bao-eng/alpinetime-hw/0.2/alpinetime.kicad_pcb

## KiCad design 0.2/alpinetime.kicad_pcb (2024-12-16)

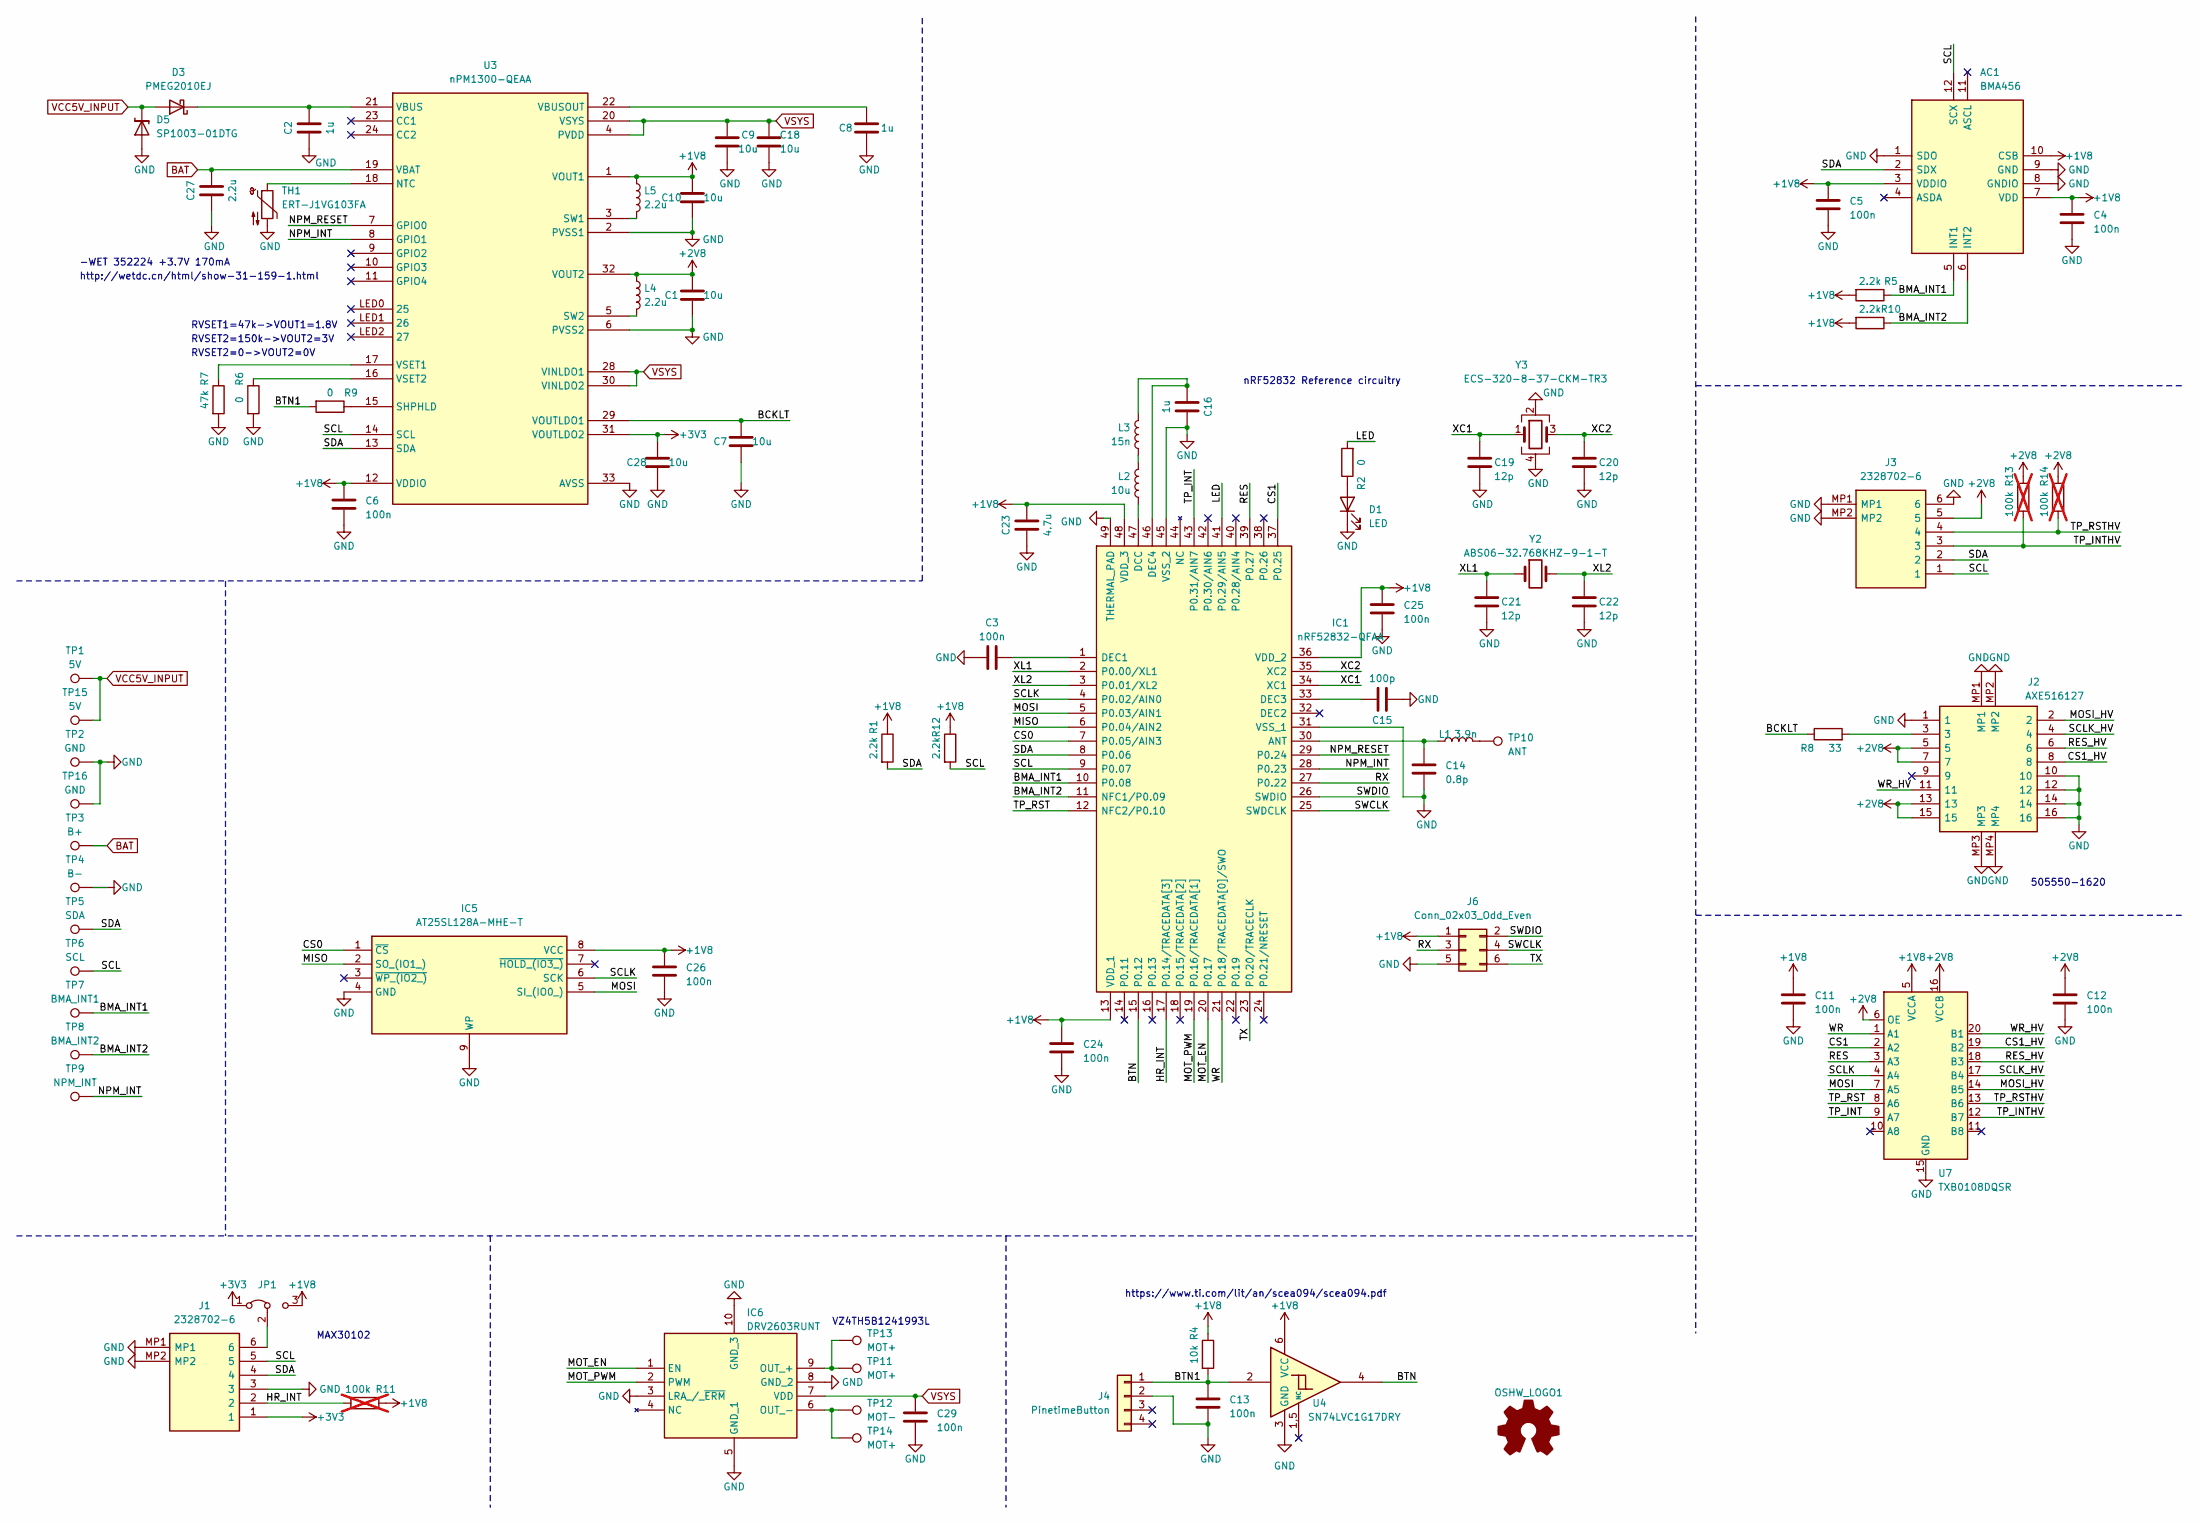
[picture p1: schematic alpinetime.kicad_sch, AlpineTime 0.2]

Parts:
AC1: BMA456; BOSCH_LGA-12; Mouser Part Number 262-BMA456
C1, C7, C9, C10, C18, C28: 10u; C_0603_1608Metric; MPN CL10A106KP8NNNC
C2, C8: 1u; C_0603_1608Metric
C3, C4, C5, C6, C11, C12, C13, C24, C25, C26, C29: 100n; C_0402_1005Metric; MPN GCM155R71C104KA55D
C14: 0.8p; C_0402_1005Metric; MPN GJM1555C1HR80WB01D
C15: 100p; C_0402_1005Metric; MPN GRM1555C1H101JA01D
C16: 1u; C_0603_1608Metric; MPN CL10B105KP8NNNC
C19, C20, C21, C22: 12p; C_0402_1005Metric; MPN GRM1555C1H120GA01D
C23: 4.7u; C_0603_1608Metric; MPN CL10A475KQ8NNNC
C27: 2.2u; C_0603_1608Metric; MPN CL10B105KP8NNNC
D1: LED; LED_0402_1005Metric; MPN APHHS1005LSECK/J3-PF
D3: PMEG2010EJ; SODFL2512X80N
D5: SP1003-01DTG; SODFL1406X65N
IC1: nRF52832-QFAA; QFN-48-1EP_6x6mm_P0.4mm_EP4.66x4.66mm; Mouser Part Number 949-NRF52832-QFAA-R7
IC5: AT25SL128A-MHE-T; SON127P600X500X60-9N-D; Mouser Part Number 988-AT25SL128A-MHE-T
IC6: DRV2603RUNT; QFN50P200X200X80-10N-D; Mouser Part Number 595-DRV2603RUNT
J1, J3: 2328702-6; 23287026; Mouser Part Number 571-2328702-6
J2: AXE516127; Mouser Part Number 679-AXE516127
J4: PinetimeButton
J6: Conn_02x03_Odd_Even; PinHeader_2x03_P1.27mm_Vertical
JP1: R_0402_1005Metric_jumper
L1: 3.9n; L_0402_1005Metric; MPN MCL1005-3R9-R
L2: 10u; L_0603_1608Metric; MPN MLZ1608M100WT000
L3: 15n; L_0402_1005Metric; MPN LQG15HS15NJ02D
L4, L5: 2.2u; CIGT201610; MPN CIGT201610EH2R2MNE
OSHW_LOGO1: Logo_Open_Hardware_Small; OSHW_logo.kicad_mod_silkscreen-front_5mm
R1, R5, R10, R12: 2.2k; R_0402_1005Metric; MPN RT0402FRE072K2L
R2: 0; R_0402_1005Metric; MPN RC0402FR-07330RL
R4: 10k; R_0402_1005Metric; MPN RT0402FRE0710KL
R6, R9: 0; R_0402_1005Metric; MPN RT0402FRE072K2L
R7: 47k; R_0402_1005Metric; MPN RT0402FRE072K2L
R8: 33; R_0402_1005Metric; MPN RT0402FRE0733RL
R11, R13, R14: 100k; R_0402_1005Metric; MPN RT0402FRE07100KL; not fitted
TH1: ERT-J1VG103FA; R_0603_1608Metric
TP1: 5V; TestPoint_Pad_D2.0mm
TP2: GND; TestPoint_Pad_D2.0mm
TP3: B+; TestPoint_Pad_Oval_1.0x2.0mm
TP4: B-; TestPoint_Pad_Oval_1.0x2.0mm
TP5: SDA; TestPoint_Pad_D1.0mm
TP6: SCL; TestPoint_Pad_D1.0mm
TP7: BMA_INT1; TestPoint_Pad_D1.0mm
TP8: BMA_INT2; TestPoint_Pad_D1.0mm
TP9: NPM_INT; TestPoint_Pad_D1.0mm
TP10: ANT; TestPoint_Pad_D1.5mm
TP11: MOT+; Pad_7.0x2.5mm
TP12: MOT-; Pad_7.0x2.5mm
TP13, TP14: MOT+; TestPoint_Pad_D1.0mm
TP15: 5V; TestPoint_Pad_D1.0mm
TP16: GND; TestPoint_Pad_D1.0mm
U3: nPM1300-QEAA; QFN-32-1EP_5x5mm_P0.5mm_EP3.3x3.3mm
U4: SN74LVC1G17DRY; SON50P100X145X60-6N
U7: TXB0108DQSR; USON-20_2x4mm_P0.4mm
Y2: ABS06-32.768KHZ-9-1-T; ABS0612732768KHZT
Y3: ECS-320-8-37-CKM-TR3; ECS320837CKMTR3

Connections:
+1V8: AC1.3 (VDDIO), AC1.7 (VDD), AC1.10 (CSB), C4.1, C5.1, C6.1, C10.2, C11.1, C23.2, C24.2, C25.2, C26.1, IC1.13 (VDD_1), IC1.36 (VDD_2), IC1.48 (VDD_3), IC5.8 (VCC), J6.1, JP1.3 (B), L5.1, R1.1, R4.1, R5.2, R10.2, R11.1, R12.1, U3.1 (VOUT1), U3.12 (VDDIO), U4.6 (VCC), U7.5 (VCCA)
+2V8: C1.2, C12.1, J2.5, J2.7, J2.13, J2.15, J3.5, L4.1, R13.1, R14.1, U3.32 (VOUT2), U7.6 (OE), U7.16 (VCCB)
+3V3: C28.2, J1.1, JP1.1 (A), U3.31 (VOUTLDO2)
/BCKLT: C7.2, R8.1, U3.29 (VOUTLDO1)
/BMA_INT1: AC1.5 (INT1), IC1.10 (P0.08), R5.1, TP7.1
/BMA_INT2: AC1.6 (INT2), IC1.11 (NFC1/P0.09), R10.1, TP8.1
/BTN: IC1.15 (P0.12), U4.4
/BTN1: C13.1, J4.1, R4.2, R9.2, U4.2
/CS0: IC1.7 (P0.05/AIN3), IC5.1 (~CS)
/CS1: IC1.37 (P0.25), U7.2 (A2)
/CS1_HV: J2.8, U7.19 (B2)
/HR_INT: IC1.17 (P0.14/TRACEDATA[3]), J1.2, R11.2
/LED: IC1.41 (P0.29/AIN5), R2.2
/MISO: IC1.6 (P0.04/AIN2), IC5.2 (SO_(IO1_))
/MOSI: IC1.5 (P0.03/AIN1), IC5.5 (SI_(IO0_)), U7.7 (A5)
/MOSI_HV: J2.2, U7.14 (B5)
/MOT_EN: IC1.20 (P0.17), IC6.1 (EN)
/MOT_PWM: IC1.19 (P0.16/TRACEDATA[1]), IC6.2 (PWM)
/NPM_INT: IC1.28 (P0.23), TP9.1, U3.8 (GPIO1)
/NPM_RESET: IC1.29 (P0.24), U3.7 (GPIO0)
/RES: IC1.39 (P0.27), U7.3 (A3)
/RES_HV: J2.6, U7.18 (B3)
/RX: IC1.27 (P0.22), J6.3
/SCL: AC1.12 (SCX), IC1.9 (P0.07), J1.5, J3.1, R12.2, TP6.1, U3.14 (SCL)
/SCLK: IC1.4 (P0.02/AIN0), IC5.6 (SCK), U7.4 (A4)
/SCLK_HV: J2.4, U7.17 (B4)
/SDA: AC1.2 (SDX), IC1.8 (P0.06), J1.4, J3.2, R1.2, TP5.1, U3.13 (SDA)
/SWCLK: IC1.25 (SWDCLK), J6.4
/SWDIO: IC1.26 (SWDIO), J6.2
/TP_INT: IC1.43 (P0.31/AIN7), U7.9 (A7)
/TP_INTHV: J3.3, R13.2, U7.12 (B7)
/TP_RST: IC1.12 (NFC2/P0.10), U7.8 (A6)
/TP_RSTHV: J3.4, R14.2, U7.13 (B6)
/TX: IC1.23 (P0.20/TRACECLK), J6.6
/WR: IC1.21 (P0.18/TRACEDATA[0]/SWO), U7.1 (A1)
/WR_HV: J2.11, U7.20 (B1)
/XC1: C19.2, IC1.34 (XC1), Y3.1
/XC2: C20.2, IC1.35 (XC2), Y3.3
/XL1: C21.2, IC1.2 (P0.00/XL1), Y2.1
/XL2: C22.2, IC1.3 (P0.01/XL2), Y2.2
BAT: C27.2, TP3.1, U3.19 (VBAT)
GND: AC1.1 (SDO), AC1.8 (GNDIO), AC1.9 (GND), C1.1, C2.1, C3.1, C4.2, C5.2, C6.2, C7.1, C8.1, C9.1, C10.1, C11.2, C12.2, C13.2, C14.1, C15.1, C16.2, C18.1, C19.1, C20.1, C21.1, C22.1, C23.1, C24.1, C25.1, C26.2, C27.1, C28.1, C29.2, D1.1 (K), D5.2 (A), IC1.31 (VSS_1), IC1.45 (VSS_2), IC1.49 (THERMAL_PAD), IC5.4 (GND), IC5.9 (WP), IC6.3 (LRA_/_~ERM), IC6.5 (GND_1), IC6.8 (GND_2), IC6.10 (GND_3), J1.3, J1.MP1, J1.MP2, J2.1, J2.10, J2.12, J2.14, J2.16, J2.MP1, J2.MP2, J2.MP3, J2.MP4, J3.6, J3.MP1, J3.MP2, J4.2, J6.5, R6.2, R7.2, TH1.2, TP2.1, TP4.1, TP16.1, U3.2 (PVSS1), U3.6 (PVSS2), U3.33 (AVSS), U4.3 (GND), U7.15 (GND), Y3.2, Y3.4
unnamed: D1.2 (A), R2.1
unnamed: C2.2, D3.1 (K), U3.21 (VBUS)
unnamed: C14.2, IC1.30 (ANT), L1.1
unnamed: IC1.47 (DCC), L2.1
unnamed: C3.2, IC1.1 (DEC1)
unnamed: C15.2, IC1.33 (DEC3)
unnamed: C16.1, IC1.46 (DEC4), L3.2
unnamed: IC6.9 (OUT_+), TP11.1, TP13.1
unnamed: IC6.6 (OUT_-), TP12.1, TP14.1
unnamed: J2.3, R8.2
unnamed: J1.6, JP1.2 (C)
unnamed: L1.2, TP10.1
unnamed: L2.2, L3.1
unnamed: TH1.1, U3.18 (NTC)
unnamed: R9.1, U3.15 (SHPHLD)
unnamed: L5.2, U3.3 (SW1)
unnamed: L4.2, U3.5 (SW2)
unnamed: C8.2, U3.22 (VBUSOUT)
unnamed: R7.1, U3.17 (VSET1)
unnamed: R6.1, U3.16 (VSET2)
VCC5V_INPUT: D3.2 (A), D5.1 (K), TP1.1, TP15.1
VSYS: C9.2, C18.2, C29.1, IC6.7 (VDD), U3.4 (PVDD), U3.20 (VSYS), U3.28 (VINLDO1), U3.30 (VINLDO2)

Notes on the sheet:
https://www.ti.com/lit/an/scea094/scea094.pdf
VZ4TH5B1241993L
RVSET2=150k->VOUT2=3V
RVSET1=47k->VOUT1=1.8V
nRF52832 Reference circuitry
http://wetdc.cn/html/show-31-159-1.html
-WET 352224 +3.7V 170mA
505550-1620
MAX30102
RVSET2=0->VOUT2=0V

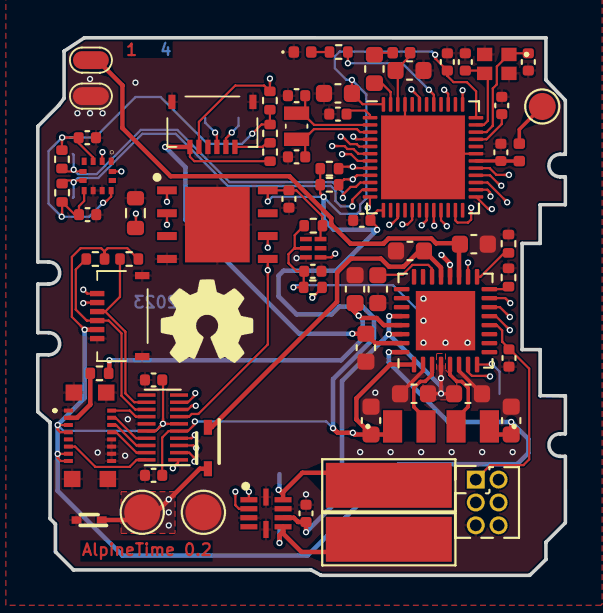
[picture p2: board 0.2/alpinetime.kicad_pcb from above]

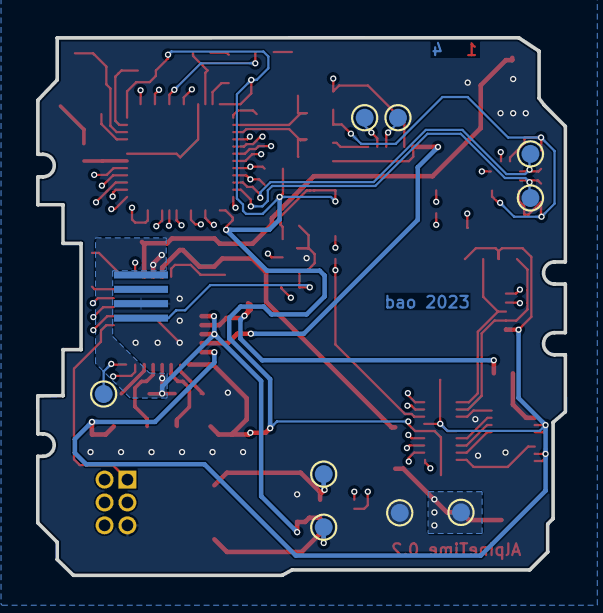
[picture p3: board 0.2/alpinetime.kicad_pcb from below]

Board: 4 copper layers, 29.3 x 29.9 mm, 82 parts (10 on the bottom side), 64 nets.
