bao-eng/alpinetime-hw/0.1/alpinetime.kicad_pcb

## KiCad design 0.1/alpinetime.kicad_pcb (2023-11-14)

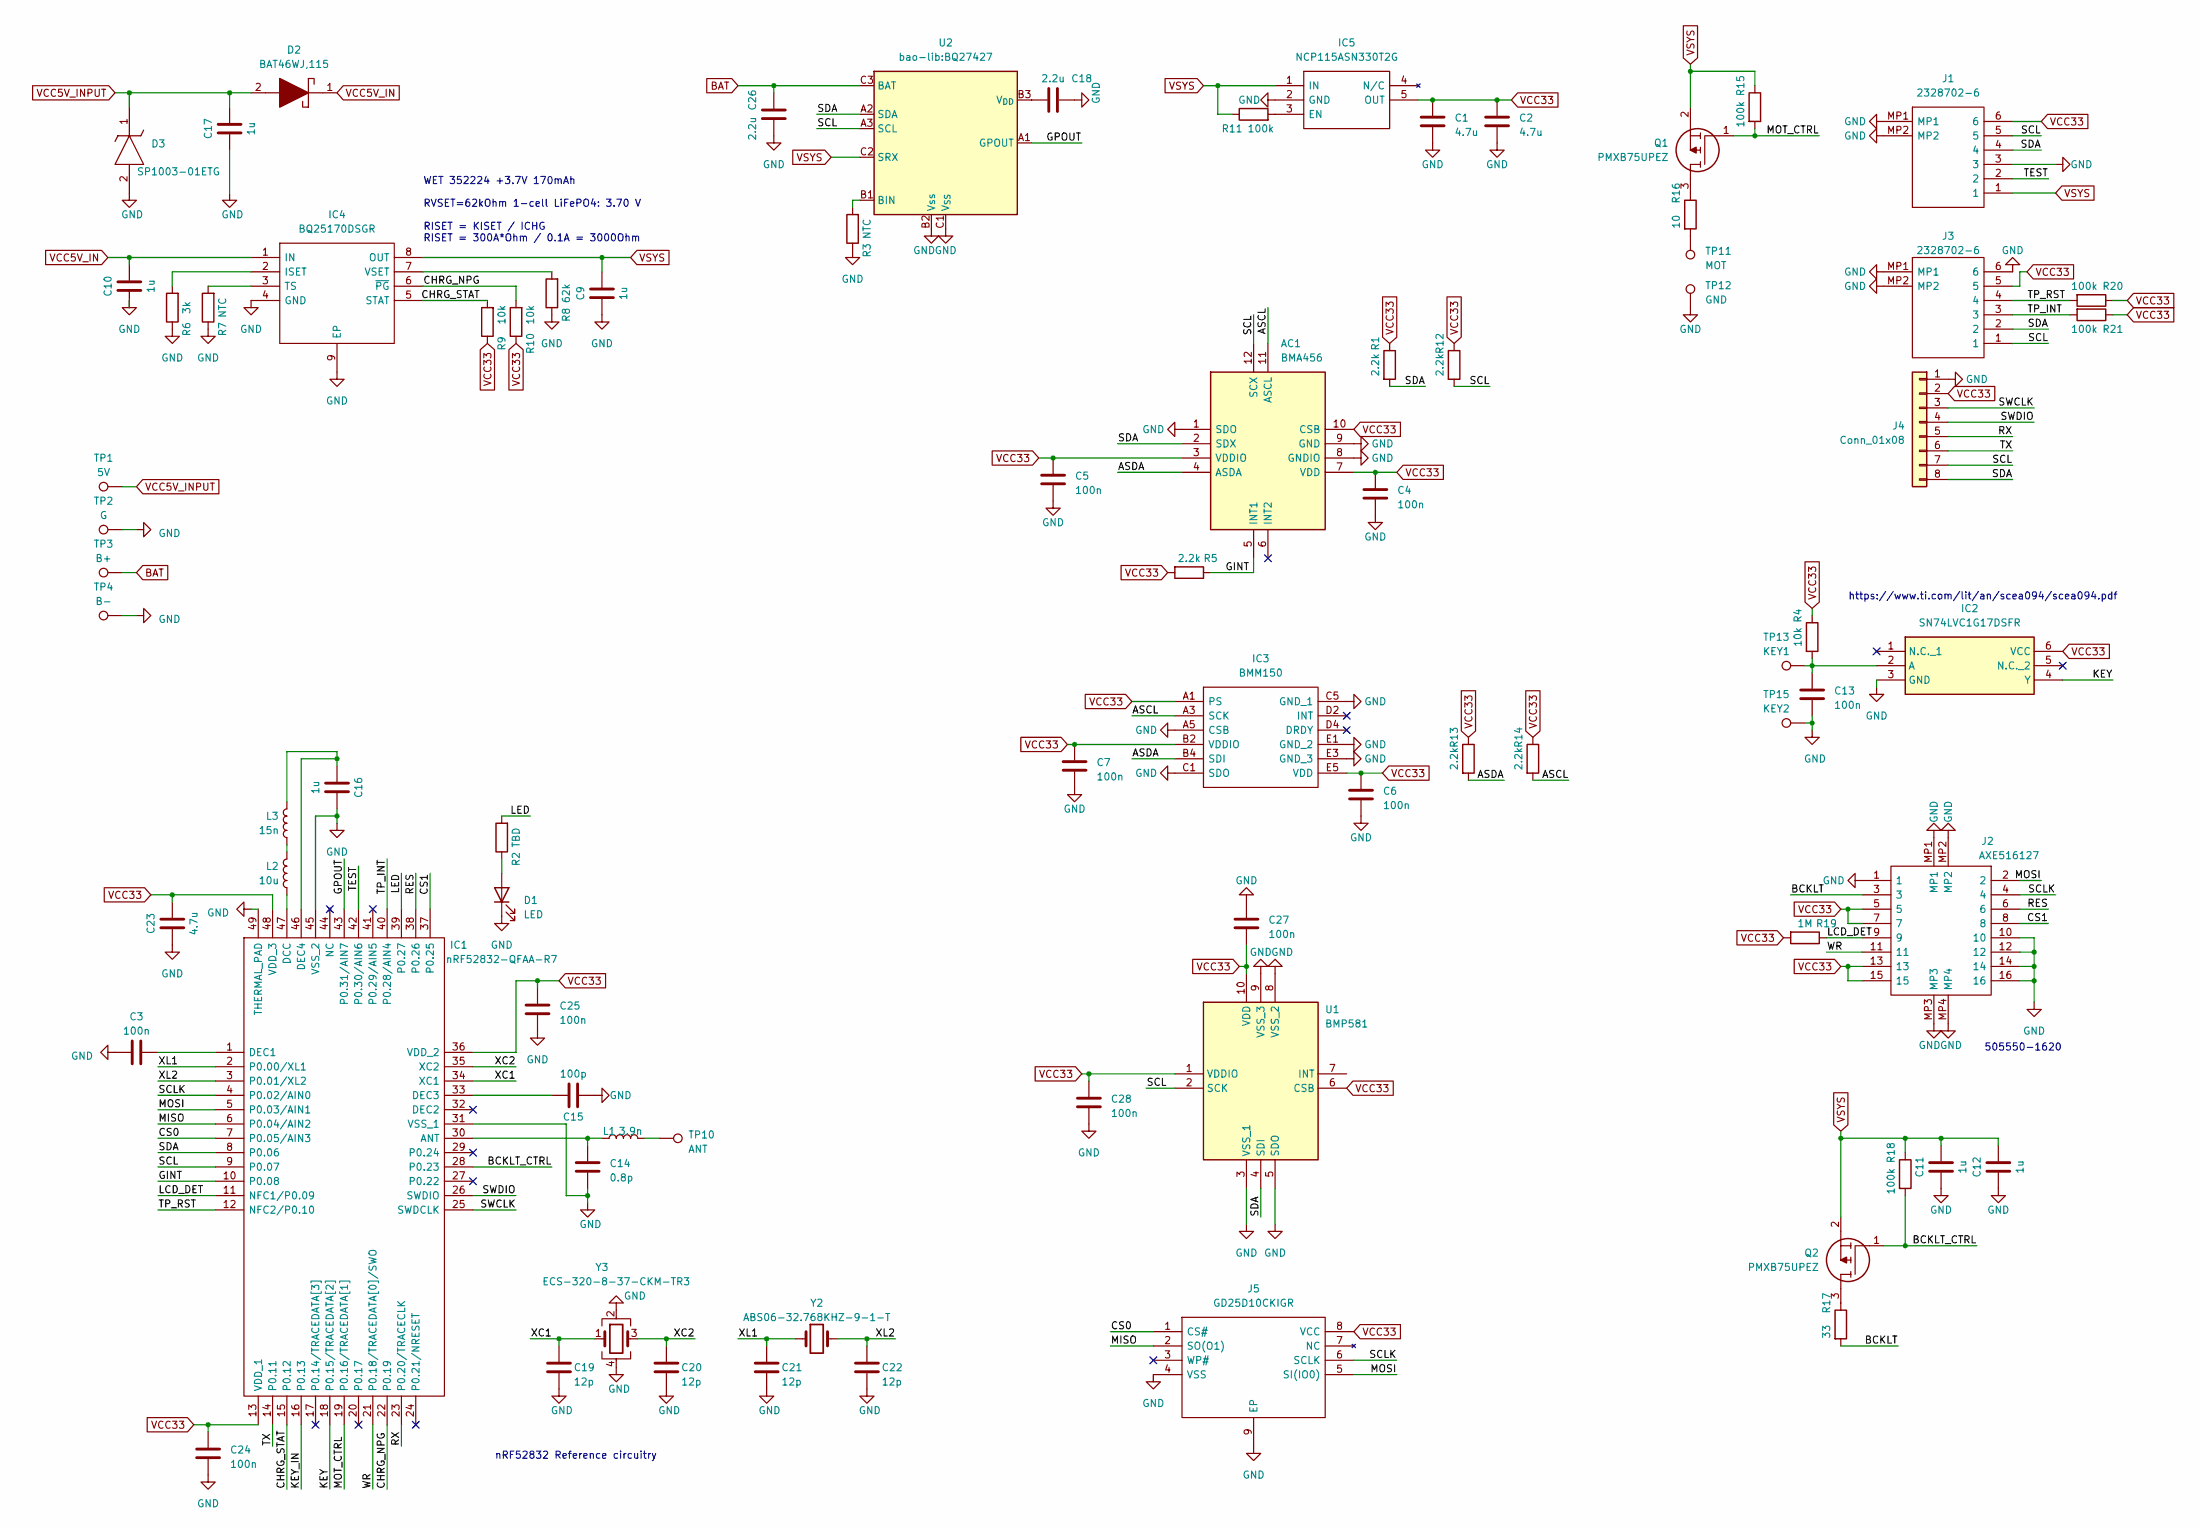
[picture p4: schematic alpinetime.kicad_sch]

Parts:
AC1: BMA456; BOSCH_LGA-12; Mouser Part Number 262-BMA456
C1, C2: 4.7u; C_0603_1608Metric; MPN CL10A475KP8NNNC
C3, C4, C5, C6, C7, C13, C24, C25, C27, C28: 100n; C_0402_1005Metric; MPN GCM155R71C104KA55D
C9, C10, C11, C12, C16, C17: 1u; C_0603_1608Metric; MPN CL10B105KP8NNNC
C14: 0.8p; C_0402_1005Metric; MPN GJM1555C1HR80WB01D
C15: 100p; C_0402_1005Metric; MPN GRM1555C1H101JA01D
C18, C26: 2.2u; C_0603_1608Metric; MPN CL10B225KP8NNNC
C19, C20, C21, C22: 12p; C_0402_1005Metric; MPN GRM1555C1H120GA01D
C23: 4.7u; C_0603_1608Metric
D1: LED; LED_0402_1005Metric; MPN LT QH9G-Q2OO-25-2Z4Y
D2: BAT46WJ,115; SODFL2512X80N; Mouser Part Number 771-BAT46WJ115
D3: SP1003-01ETG; SOD882; Mouser Part Number 576-SP1003-01ETG
IC1: nRF52832-QFAA-R7; QFN40P600X600X90-49N-D; Mouser Part Number 949-NRF52832-QFAA-R7
IC2: SN74LVC1G17DSFR; SON35P100X100X40-6N; Mouser Part Number 595-SN74LVC1G17DSFR
IC3: BMM150; Mouser Part Number 262-BMM150
IC4: BQ25170DSGR; SON50P200X200X80-9N; Mouser Part Number 595-BQ25170DSGR
IC5: NCP115ASN330T2G; SOT95P275X110-5N; Mouser Part Number 863-NCP115ASN330T2G
J1, J3: 2328702-6; 23287026; Mouser Part Number 571-2328702-6
J2: AXE516127; Mouser Part Number 679-AXE516127
J4: Conn_01x08; PinSocket_1x08_P1.27mm_Vertical
J5: GD25D10CKIGR; SON40P150X150X50-9N; Mouser Part Number 363-GD25D10CKIGR
L1: 3.9n; L_0402_1005Metric; MPN MCL1005-3R9-R
L2: 10u; L_0603_1608Metric; MPN MLZ1608M100WT000
L3: 15n; L_0402_1005Metric; MPN LQG15HS15NJ02D
Q1, Q2: PMXB75UPEZ; Mouser Part Number 771-PMXB75UPEZ
R1, R5, R12, R13, R14: 2.2k; R_0402_1005Metric; MPN RT0402FRE072K2L
R2: TBD; R_0402_1005Metric
R3, R7: NTC; R_0402_1005Metric; MPN 103KT1005T-1P
R4, R9, R10: 10k; R_0402_1005Metric; MPN RT0402FRE0710KL
R6: 3k; R_0402_1005Metric; MPN ERA-2AEB302X
R8: 62k; R_0402_1005Metric; MPN RT0402BRD0762KL
R11, R15, R18, R20, R21: 100k; R_0402_1005Metric; MPN RT0402FRE07100KL
R16: 10; R_0402_1005Metric; MPN RT0402FRE0710RL
R17: 33; R_0402_1005Metric; MPN RT0402FRE0733RL
R19: 1M; R_0402_1005Metric; MPN RC0402FR-131ML
TP1: 5V; TestPoint_Pad_D2.0mm
TP2: G; TestPoint_Pad_D2.0mm
TP3: B+; TestPoint_Pad_D1.5mm
TP4: B-; TestPoint_Pad_D1.5mm
TP10: ANT; TestPoint_Pad_D1.5mm
TP11: MOT; TestPoint_Pad_2.0x2.0mm
TP12: GND; TestPoint_Pad_2.0x2.0mm
TP13: KEY1; TestPoint_Pad_2.0x2.0mm
TP15: KEY2; TestPoint_Pad_2.0x2.0mm
U1: BMP581; Mouser Part Number 262-BMP581
U2: bao-lib:BQ27427; Texas_DSBGA-9_1.4715x1.4715mm_Layout3x3_P0.5mm
Y2: ABS06-32.768KHZ-9-1-T; ABS0612732768KHZT
Y3: ECS-320-8-37-CKM-TR3; ECS320837CKMTR3

Connections:
/ASCL: AC1.11 (ASCL), IC3.A3 (SCK), R14.2
/ASDA: AC1.4 (ASDA), IC3.B4 (SDI), R13.2
/BCKLT: J2.3, R17.2
/BCKLT_CTRL: IC1.28 (P0.23), Q2.1, R18.2
/CHRG_NPG: IC1.22 (P0.19), IC4.6 (~PG), R10.2
/CHRG_STAT: IC1.15 (P0.12), IC4.5 (STAT), R9.2
/CS0: IC1.7 (P0.05/AIN3), J5.1 (CS#)
/CS1: IC1.37 (P0.25), J2.8
/GINT: AC1.5 (INT1), IC1.10 (P0.08), R5.1
/GPOUT: IC1.43 (P0.31/AIN7), U2.A1 (GPOUT)
/KEY: IC1.18 (P0.15/TRACEDATA[2]), IC2.4 (Y)
/KEY_IN: IC1.16 (P0.13)
/LCD_DET: IC1.11 (NFC1/P0.09), J2.9, R19.1
/LED: IC1.39 (P0.27), R2.2
/MISO: IC1.6 (P0.04/AIN2), J5.2 (SO(O1))
/MOSI: IC1.5 (P0.03/AIN1), J2.2, J5.5 (SI(IO0))
/MOT_CTRL: IC1.19 (P0.16/TRACEDATA[1]), Q1.1, R15.2
/RES: IC1.38 (P0.26), J2.6
/RX: IC1.23 (P0.20/TRACECLK), J4.5
/SCL: AC1.12 (SCX), IC1.9 (P0.07), J1.5, J3.1, J4.7, R12.2, U1.2 (SCK), U2.A3 (SCL)
/SCLK: IC1.4 (P0.02/AIN0), J2.4, J5.6 (SCLK)
/SDA: AC1.2 (SDX), IC1.8 (P0.06), J1.4, J3.2, J4.8, R1.2, U1.4 (SDI), U2.A2 (SDA)
/SWCLK: IC1.25 (SWDCLK), J4.3
/SWDIO: IC1.26 (SWDIO), J4.4
/TEST: IC1.42 (P0.30/AIN6), J1.2
/TP_INT: IC1.40 (P0.28/AIN4), J3.3, R21.2
/TP_RST: IC1.12 (NFC2/P0.10), J3.4, R20.2
/TX: IC1.14 (P0.11), J4.6
/WR: IC1.21 (P0.18/TRACEDATA[0]/SWO), J2.11
/XC1: C19.2, IC1.34 (XC1), Y3.1
/XC2: C20.2, IC1.35 (XC2), Y3.3
/XL1: C21.2, IC1.2 (P0.00/XL1), Y2.1
/XL2: C22.2, IC1.3 (P0.01/XL2), Y2.2
BAT: C26.1, TP3.1, U2.C3 (BAT)
GND: AC1.1 (SDO), AC1.8 (GNDIO), AC1.9 (GND), C1.2, C2.2, C3.1, C4.2, C5.2, C6.2, C7.2, C9.1, C10.1, C11.1, C12.1, C13.2, C14.1, C15.1, C16.2, C17.1, C18.1, C19.1, C20.1, C21.1, C22.1, C23.1, C24.1, C25.1, C26.2, C27.1, C28.2, D1.1 (K), D3.2, IC1.31 (VSS_1), IC1.45 (VSS_2), IC1.49 (THERMAL_PAD), IC2.3 (GND), IC3.A5 (CSB), IC3.C1 (SDO), IC3.C5 (GND_1), IC3.E1 (GND_2), IC3.E3 (GND_3), IC4.4 (GND), IC4.9 (EP), IC5.2 (GND), J1.3, J1.MP1, J1.MP2, J2.1, J2.10, J2.12, J2.14, J2.16, J2.MP1, J2.MP2, J2.MP3, J2.MP4, J3.6, J3.MP1, J3.MP2, J4.1, J5.4 (VSS), J5.9 (EP), R3.1, R6.1, R7.1, R8.1, TP2.1, TP4.1, TP12.1, TP15.1, U1.3 (VSS_1), U1.5 (SDO), U1.8 (VSS_2), U1.9 (VSS_3), U2.B2 (Vss), U2.C1 (V_{SS}), Y3.2, Y3.4
unnamed: D1.2 (A), R2.1
unnamed: C14.2, IC1.30 (ANT), L1.1
unnamed: IC1.47 (DCC), L2.1
unnamed: C3.2, IC1.1 (DEC1)
unnamed: C15.2, IC1.33 (DEC3)
unnamed: C16.1, IC1.46 (DEC4), L3.2
unnamed: C13.1, IC2.2 (A), R4.2, TP13.1
unnamed: IC4.2 (ISET), R6.2
unnamed: IC4.3 (TS), R7.2
unnamed: IC4.7 (VSET), R8.2
unnamed: IC5.3 (EN), R11.2
unnamed: L1.2, TP10.1
unnamed: L2.2, L3.1
unnamed: Q1.3, R16.1
unnamed: Q2.3, R17.1
unnamed: R16.2, TP11.1
unnamed: R3.2, U2.B1 (BIN)
unnamed: C18.2, U2.B3 (V_{DD})
VCC5V_IN: C10.2, D2.1, IC4.1 (IN)
VCC5V_INPUT: C17.2, D2.2, D3.1, TP1.1
VCC33: AC1.3 (VDDIO), AC1.7 (VDD), AC1.10 (CSB), C1.1, C2.1, C4.1, C5.1, C6.1, C7.1, C23.2, C24.2, C25.2, C27.2, C28.1, IC1.13 (VDD_1), IC1.36 (VDD_2), IC1.48 (VDD_3), IC2.6 (VCC), IC3.A1 (PS), IC3.B2 (VDDIO), IC3.E5 (VDD), IC5.5 (OUT), J1.6, J2.5, J2.7, J2.13, J2.15, J3.5, J4.2, J5.8 (VCC), R1.1, R4.1, R5.2, R9.1, R10.1, R12.1, R13.1, R14.1, R19.2, R20.1, R21.1, U1.1 (VDDIO), U1.6 (CSB), U1.10 (VDD)
VSYS: C9.2, C11.2, C12.2, IC4.8 (OUT), IC5.1 (IN), J1.1, Q1.2, Q2.2, R11.1, R15.1, R18.1, U2.C2 (SRX)

Notes on the sheet:
https://www.ti.com/lit/an/scea094/scea094.pdf
RVSET=62kOhm 1-cell LiFePO4: 3.70 V RISET = KISET / ICHG RISET = 300A*Ohm / 0.1A = 3000Ohm
nRF52832 Reference circuitry
WET 352224 +3.7V 170mAh
505550-1620

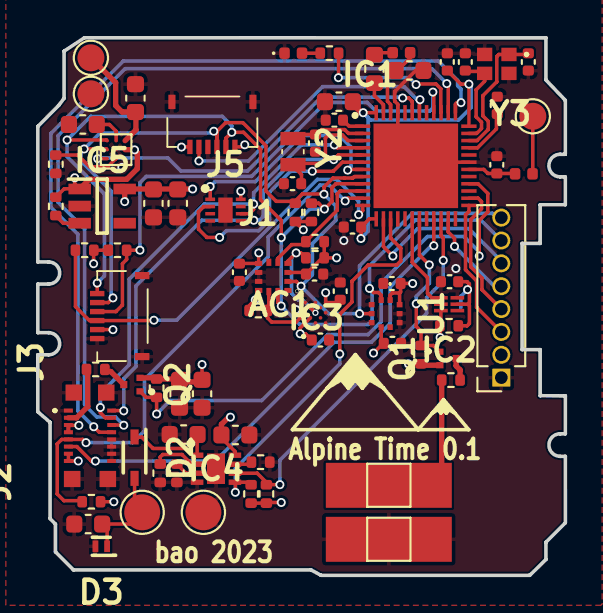
[picture p5: board 0.1/alpinetime.kicad_pcb from above]

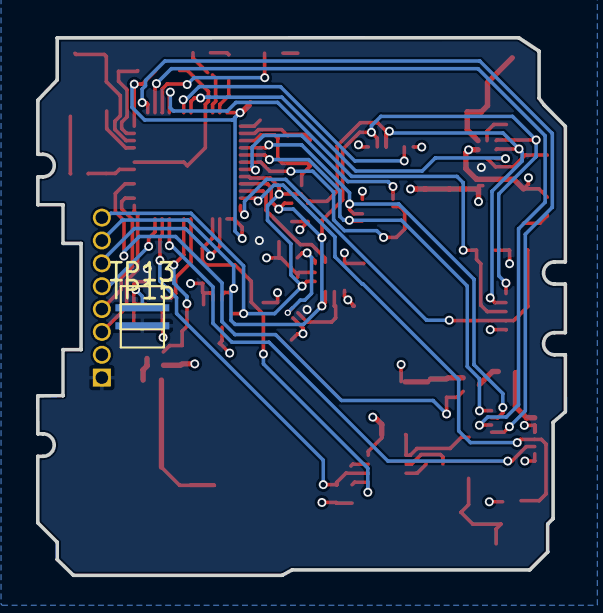
[picture p6: board 0.1/alpinetime.kicad_pcb from below]

Board: 4 copper layers, 29.3 x 29.9 mm, 80 parts (2 on the bottom side), 56 nets.
