bao-eng/alpinetime-hw/(commit log)

2023-11-14 kicad library subproject added
2023-11-14 alpinetime 0.1 uploaded
    [alpinetime.kicad_pcb, alpinetime.kicad_sch]
2023-11-15 value property fixed
    [alpinetime.kicad_sch]
2024-12-16 alpinetime 0.2 uploaded
    [alpinetime.kicad_pcb, alpinetime.kicad_sch]
